StephenRhen/ASG1/ASG1_sch.pdf

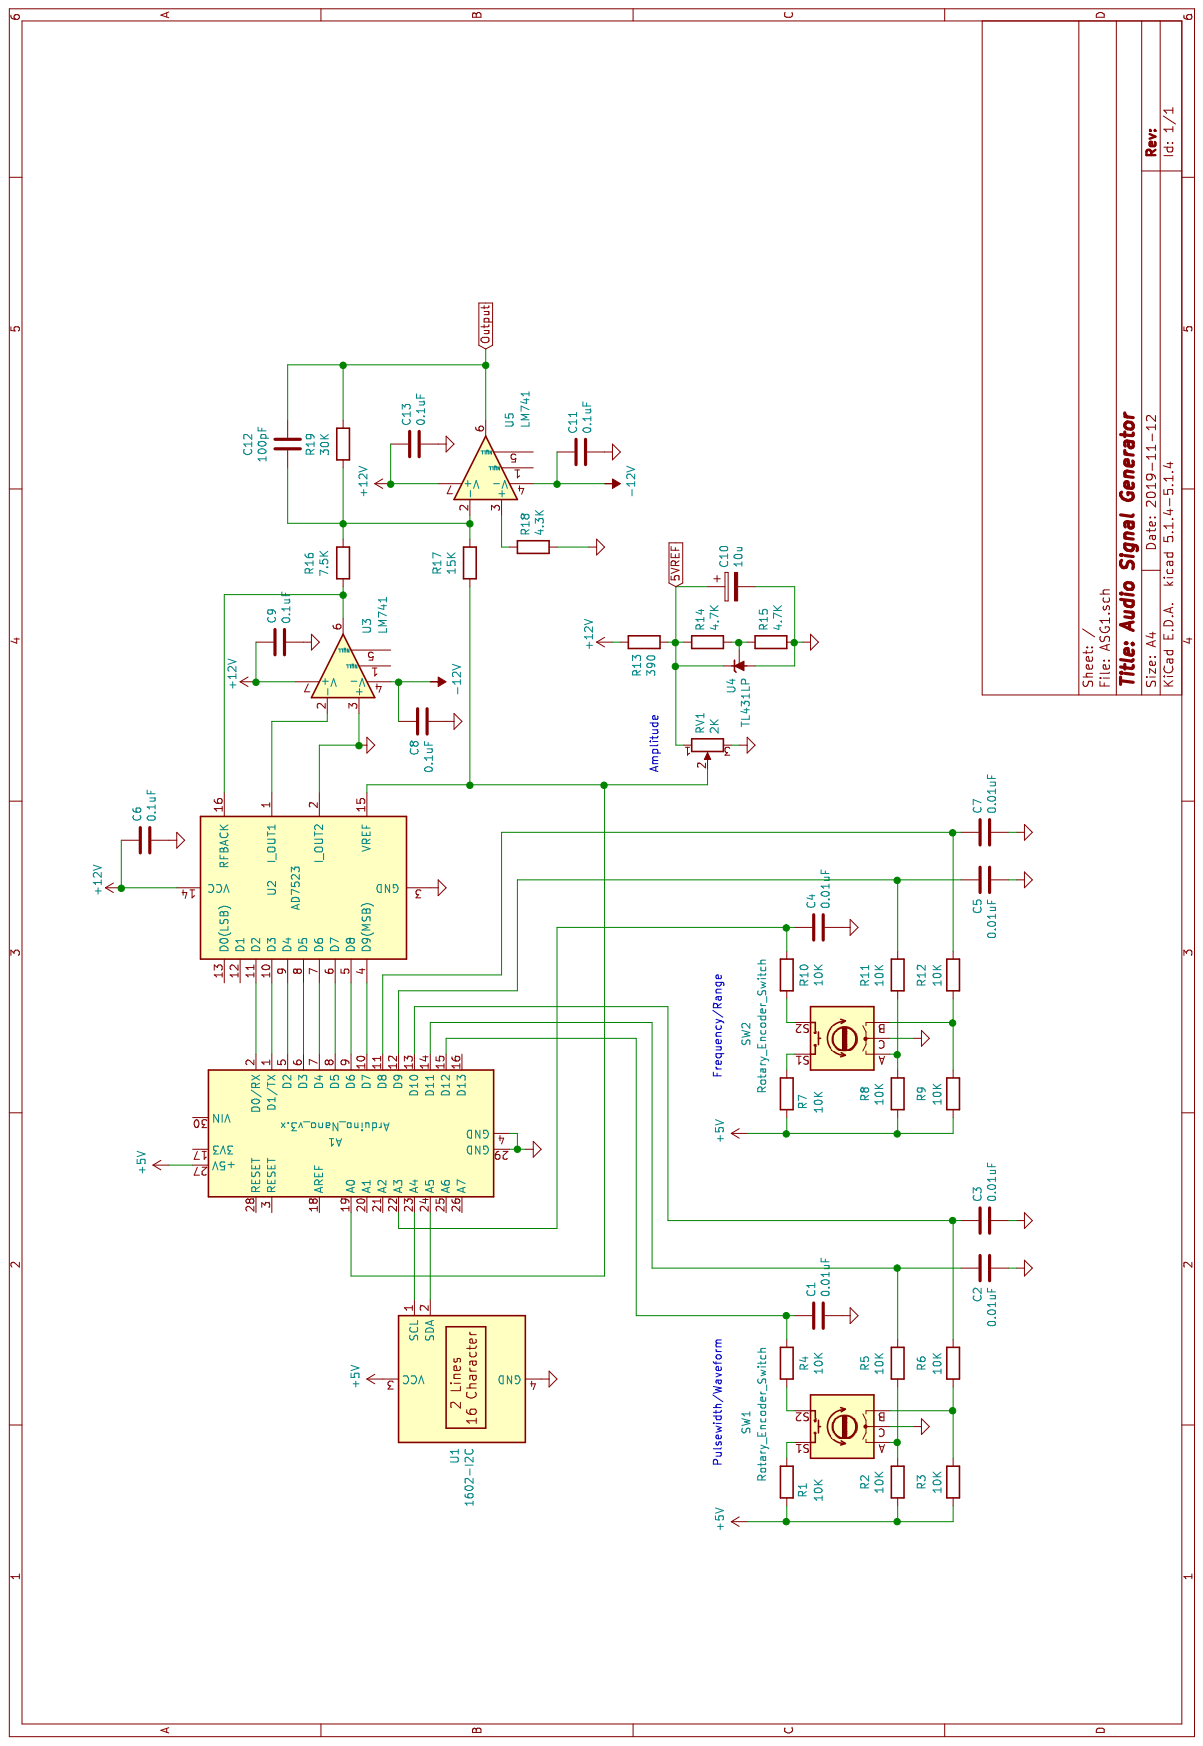
[picture p1: page 1]
