StephenRhen/ASG1/ASG1.sch

## KiCad design ASG1.sch (2019-11-12)

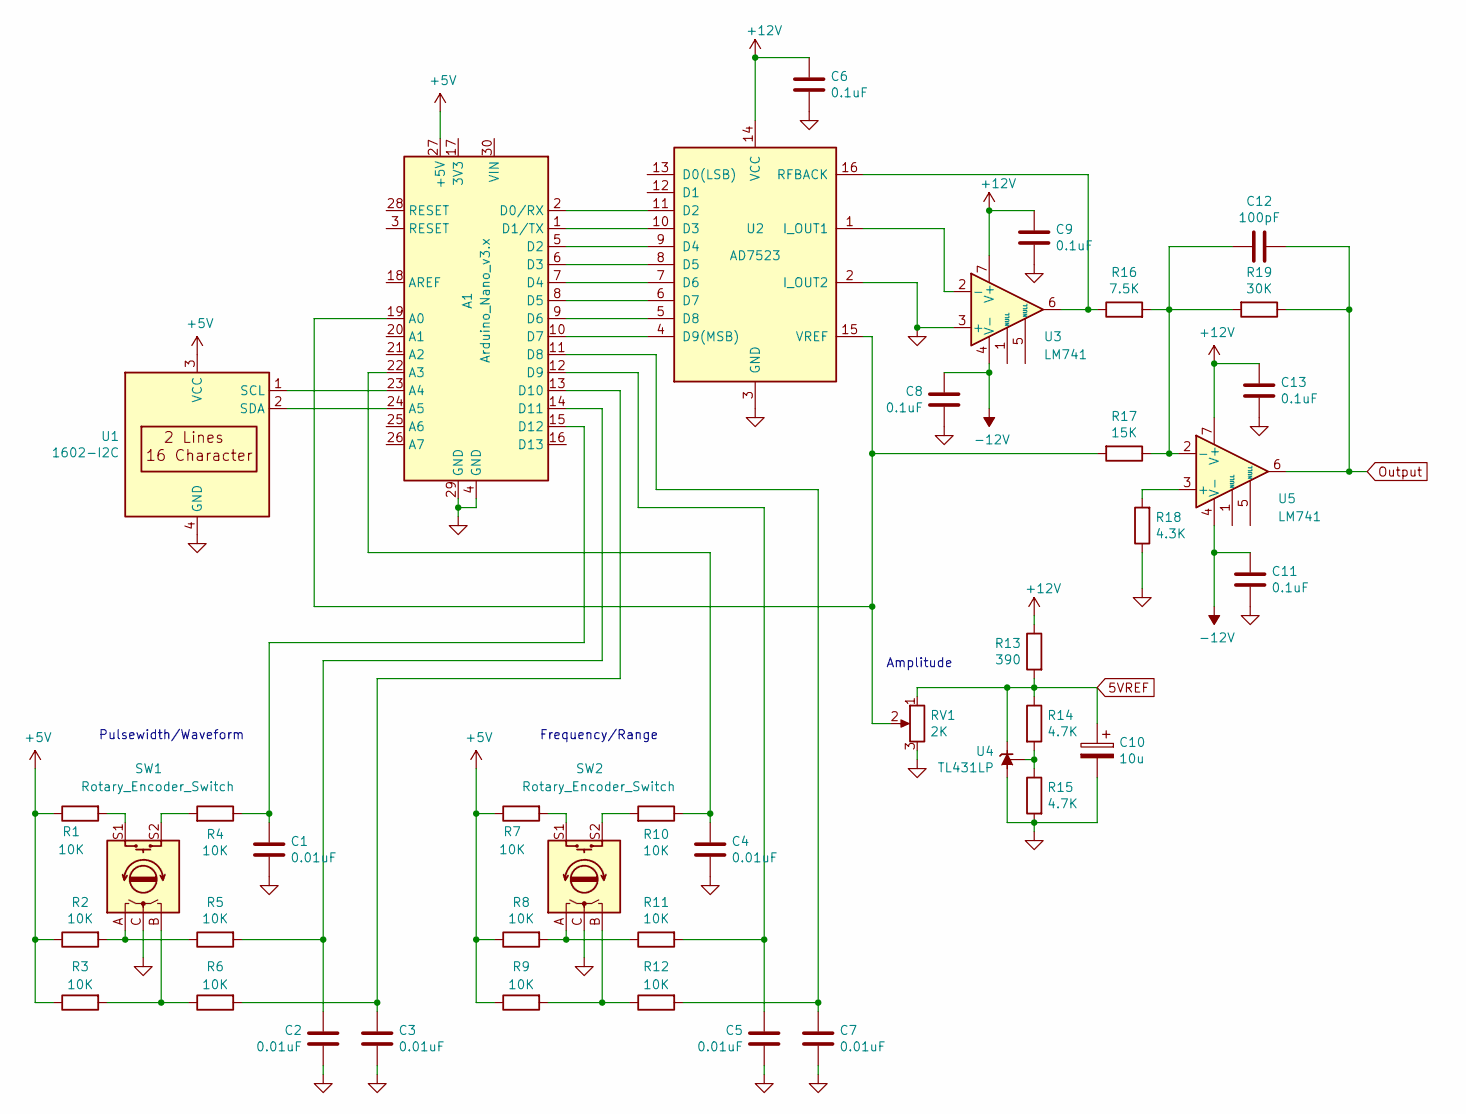
[picture p2: schematic ASG1.sch]

Parts:
A1: Arduino_Nano_v3.x; Arduino_Nano
C1, C2, C3, C4, C5, C7: 0.01uF
C6, C8, C9, C11, C13: 0.1uF
C10: 10u
C12: 100pF
R1, R2, R3, R4, R5, R6, R7, R8, R9, R10, R11, R12: 10K
R13: 390
R14, R15: 4.7K
R16: 7.5K
R17: 15K
R18: 4.3K
R19: 30K
RV1: 2K
SW1, SW2: Rotary_Encoder_Switch
U1: 1602-I2C
U2: AD7523
U3, U5: LM741
U4: TL431LP; TO-92_Inline

Connections:
5VREF: C10.1, R13.2, R14.1, RV1.1, U4.3 (K)
+5V: A1.27 (+5V), R1.1, R2.1, R3.1, R7.1, R8.1, R9.1, U1.3 (VCC)
+12V: C6.2, C9.2, C13.2, R13.1, U2.14 (VCC), U3.7 (V+), U5.7 (V+)
-12V: C8.2, C11.2, U3.4 (V-), U5.4 (V-)
GND: A1.4 (GND), A1.29 (GND), C1.2, C2.2, C3.2, C4.2, C5.2, C6.1, C7.2, C8.1, C9.1, C10.2, C11.1, C13.1, R15.2, R18.1, RV1.3, SW1.C, SW2.C, U1.4 (GND), U2.2 (I_OUT2), U2.3 (GND), U3.3 (+), U4.2 (A)
unnamed: A1.1 (D1/TX), U2.10 (D3)
unnamed: A1.2 (D0/RX), U2.11 (D2)
unnamed: A1.5 (D2), U2.9 (D4)
unnamed: A1.6 (D3), U2.8 (D5)
unnamed: A1.7 (D4), U2.7 (D6)
unnamed: A1.8 (D5), U2.6 (D7)
unnamed: A1.9 (D6), U2.5 (D8)
unnamed: A1.10 (D7), U2.4 (D9(MSB))
unnamed: A1.11 (D8), C7.1, R12.2
unnamed: A1.12 (D9), C5.1, R11.2
unnamed: A1.13 (D10), C3.1, R6.2
unnamed: A1.14 (D11), C2.1, R5.2
unnamed: A1.15 (D12), C1.1, R4.1
unnamed: A1.19 (A0), R17.2, RV1.2, U2.15 (VREF)
unnamed: A1.22 (A3), C4.1, R10.1
unnamed: A1.23 (A4), U1.1 (SCL)
unnamed: A1.24 (A5), U1.2 (SDA)
unnamed: C12.2, R16.2, R17.1, R19.2, U5.2 (-)
unnamed: R1.2, SW1.S1
unnamed: R2.2, R5.1, SW1.A
unnamed: R3.2, R6.1, SW1.B
unnamed: R4.2, SW1.S2
unnamed: R7.2, SW2.S1
unnamed: R10.2, SW2.S2
unnamed: R8.2, R11.1, SW2.A
unnamed: R9.2, R12.1, SW2.B
unnamed: R14.2, R15.1, U4.1 (REF)
unnamed: R16.1, U2.16 (RFBACK), U3.6
unnamed: R18.2, U5.3 (+)
unnamed: U2.1 (I_OUT1), U3.2 (-)
Output: C12.1, R19.1, U5.6

Notes on the sheet:
Pulsewidth/Waveform
Frequency/Range
Amplitude
