StephenRhen/ASG1/(commit log)

2019-11-03 Add files via upload
    Initial import of KiCad files.
    [ASG1.sch]
2019-11-05 Arduino sketch for the signal generator.
2019-11-12 Initial working version
    [ASG1.sch]
2019-11-12 Added pdf version of the schematic
2019-11-12 Fixed schematic annotations
    [ASG1.sch]
2020-01-14 added encoder test
